ctapang/CondoUnitAvalonGen2/BCMINER V2-1 GERBER FILES/Images/_bcminer.bmp

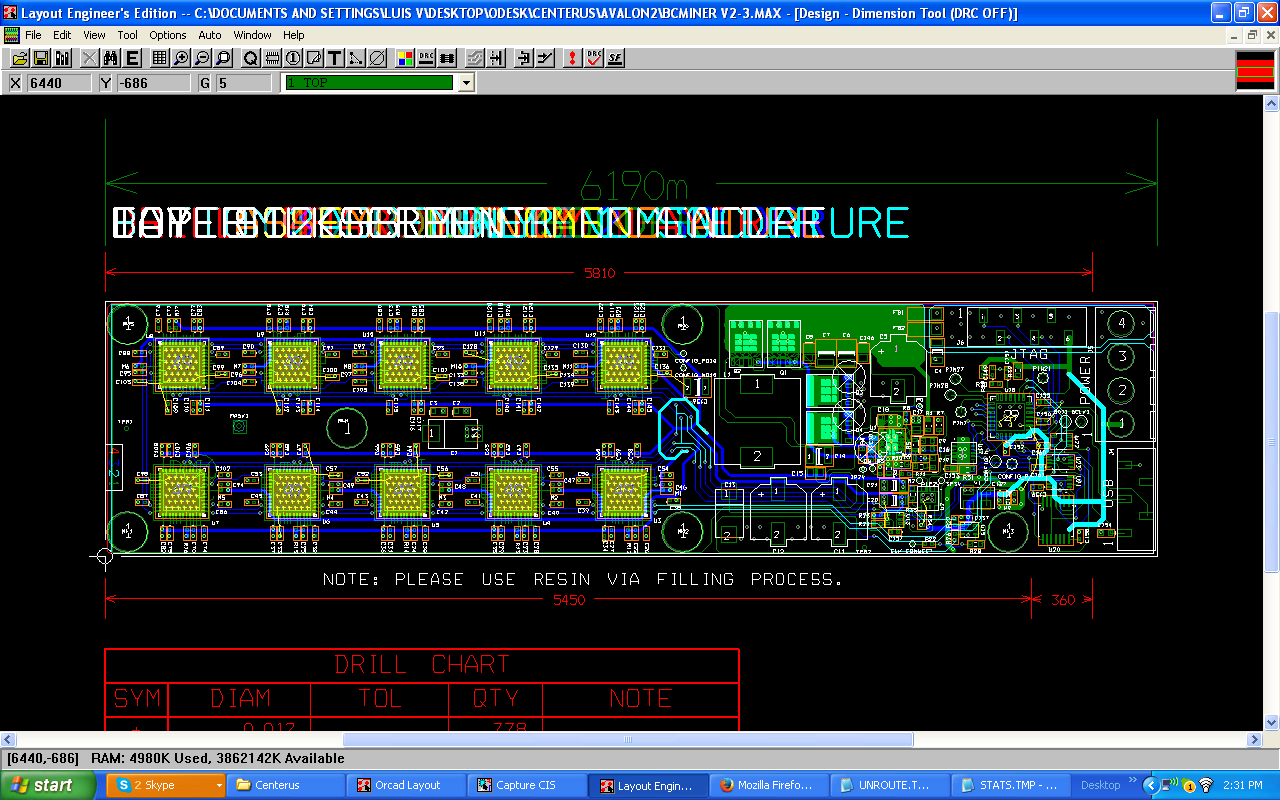
BCMINER V2-1 GERBER FILES/Images/_bcminer.bmp
