ctapang/CondoUnitAvalonGen2/BCMINER V2-1 GERBER FILES/Images/BCMINER V2-1 ASSY_CROPPED.png

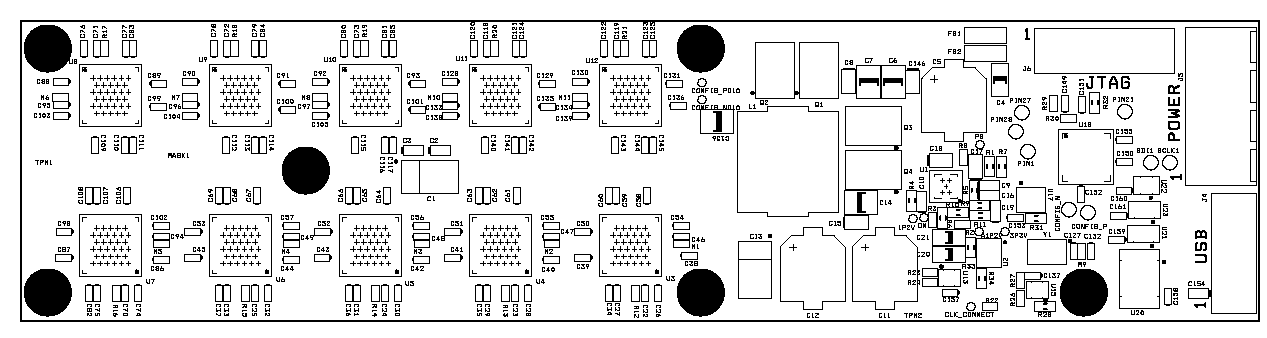
BCMINER V2-1 GERBER FILES/Images/BCMINER V2-1 ASSY_CROPPED.png
