ctapang/CondoUnitAvalonGen2/BCMINER V2-1 ORCAD FILES/BCMINER V2-1 BOM.xlsx

POWER SUPPLY Revised: Friday, November 22, 2013 |  |  |  |  |  | Page1
1000-001 Revision: 2-1
Centerus, Inc.
Bill Of Materials November 22,2013 13:20:07
Item | Quantity | Reference | Value | Description | Part Number | Manufacturer
1 | 2 | C1,C13 | 680uF/2.5V | CAP TANT 680UF 2.5V 20% 2917 | T530D687M2R5ATE010 | KEMET
2 | 2 | C2,C3 | 4.7uF | CAP CER 4.7UF 10V 10% X5R 0603 | CGB3B1X5R1A475K055AC | TDK
3 | 1 | C4 | 10uF/16V | CAP CER 10UF 16V 20% X7R 1206 | C3216X7R1C106M160AC | TDK
4 | 1 | C5 | 270uF/16V | CAP ALUM 270UF 16V 20% SMD | PCV1C271MCL1GS | NICHIHON
5 | 2 | C6,C7 | 22uF/16V | CAP CER 22UF 16V 20% X7R 1210 | C3225X7R1C226M250AC | TDK
6 | 3 | C8,C17,C146 | 4.7uF/16V | CAP CER 4.7UF 16V 10% X7R 0805 | CGA4J3X7R1C475K125AB | TDK
7 | 1 | C9 | 6800pF | CAP CER 6800PF 50V 20% X7R 0603 | CEU3E2X7R1H682M080AE | TDK
8 | 2 | C10,C154 | 1uF/20V | CAP CER 1UF 25V 10% X7R 0603 | C1608X7R1E105K080AB | TDK
9 | 2 | C11,C12 | 1500uF/2.5V | CAP ALUM 1500UF 2.5V 20% SMD | PCJ0E152MCL1GS | NICHIHON
10 | 2 | C14,C156 | 47uF | CAP CER 47UF 10V 20% X5R 1210 | LMK325BJ476MM-T | TAIYO YUDEN
11 | 2 | C15,C18 | 10uF | CAP CER 10UF 10V 10% X5R 0805 | C2012X5R1A106K125AB | TDK
12 | 1 | C16 | 390pF | CAP CER 390PF 50V 5% NP0 0603 | C1608C0G1H391J080AA | TDK
13 | 1 | C19 | 4700pF | CAP CER 4700PF 50V 5% NP0 0603 | C1608C0G1H472J080AA | TDK
14 | 2 | C20,C21 | 22uF/10V | CAP CER 22UF 10V 20% X5R 1206 | C3216X5R1A226M160AC | TDK
15 | 124 | C22,C23,C24,C25,C26,C27,C28,C29,C30,C31,C32,C33,C34,C35,C36,C37,C38,C39,C40,C41,C42,C43,C44,C45,C46,C47,C48,C49,C50,C51,C52,C53,C54,C55,C56,C57,C58,C59,C60,C61,C62,C63,C64,C65,C66,C67,C68,C69,C70,C71,C72,C73,C74,C75,C76,C77,C78,C79,C80,C81,C82,C83,C84,C85,C86,C87,C88,C89,C90,C91,C92,C93,C94,C95,C96,C97,C98,C99,C100,C101,C102,C103,C104,C105,C106,C107,C108,C109,C110,C111,C112,C113,C114,C115,C116,C117,C118,C119,C120,C121,C122,C123,C124,C125,C127,C128,C129,C130,C131,C132,C133,C134,C135,C136,C137,C138,C139,C140,C141,C142,C143,C144,C145,C157 | 0.47uF | CAP CER 0.47UF 6.3V 10% X5R 0402 | C1005X5R0J474K050BB | TDK
16 | 10 | C149,C150,C151,C152,C153,C155,C158,C159,C160,C161 | 0.1uF | CAP CER 0.1UF 6.3V 10% X5R 0402 | C1005X5R0J104K050BA | TDK
17 | 2 | FB1,FB2 | MB | FERRITE BEAD 30 OHM 3.0A 1210 | 742792310 | WURTH
18 | 1 | J4 | USB | 5POS SIL VERTICAL SMT HEADER | M20-8770546 | HARWIN
19 | 1 | J5 | POWER | TERM BLOCK PCB 4POS 5.0MM GREEN | 1935187 | PHOENIX
20 | 1 | J6 | JTAG | 6POS SIL VERTICAL SMT HEADER | M20-8770646 | HARWIN
21 | 1 | L1 | IHLP5050FDER | INDUCTOR POWER 1.0UH 32A SMD | IHLP5050FDER1R0M01 | VISHAY
22 | 11 | M1,M2,M3,M4,M5,M6,M7,M8,M9,M10,M11 | MB | FERRITE CHIP .5A 60 OHM SMD 0402 | LI0402E600R-10 | LAIRD
23 | 1 | Q1 | CSD16321Q5C | MOSFET N-CH 25V 100A 8SON | CSD16321Q5C | TI
24 | 2 | Q3,Q4 | CSD16403Q5A | MOSFET N-CH 25V 100A 8-SON | CSD16403Q5A | TI
25 | 5 | R1,R4,R26,R27,R28 | 0R | RES 0.0 OHM 1/10W JUMP 0603 SMD | ERJ-3GEY0R00V | PANASONIC
26 | 1 | R3 | 1K | RES 1K OHM 1/10W 1% 0402 SMD | ERJ-2RKF1001X | PANASONIC
27 | 1 | R5 | 7.32K | RES 7.32K OHM 1/10W 1% 0603 SMD | ERJ-3EKF7321V | PANASONIC
28 | 1 | R6 | 10K | RES 10K OHM 1/10W 1% 0603 SMD | ERJ-3EKF1002V | PANASONIC
29 | 1 | R7 | 3.9K | RES 3.9K OHM 1/10W 1% 0603 SMD | ERJ-3EKF3901V | PANASONIC
30 | 11 | R8,R12,R13,R14,R15,R16,R17,R18,R19,R20,R21 | 100K | RES 100K OHM 1/10W 1% 0402 SMD | ERJ-2RKF1003X | PANASONIC
31 | 1 | R9 | 3.32K 1% | RES 3.32K OHM 1/10W 1% 0603 SMD | ERJ-3EKF3321V | PANASONIC
32 | 1 | R10 | 3.83K 1% | RES 3.83K OHM 1/10W 1% 0603 SMD | ERJ-3EKF3831V | PANASONIC
33 | 1 | R11 | 549R | RES 549 OHM 1/10W 1% 0603 SMD | ERJ-3EKF5490V | PANASONIC
34 | 1 | R22 | 100R | RES 100 OHM 1/10W 1% 0402 SMD | ERJ-2RKF1000X | PANASONIC
35 | 3 | R23,R24,R30 | 470R | RES 470 OHM 1/10W 1% 0402 SMD | ERJ-2RKF4700X | PANASONIC
36 | 1 | R29 | 10K | RES 10K OHM 1/10W 1% 0402 SMD | ERJ-2RKF1002X | PANASONIC
37 | 1 | R31 | 51.1K | RES 51.1K OHM 1/10W 1% 0603 SMD | ERJ-3EKF5112V | PANASONIC
38 | 1 | R32 | 10R | RES 10 OHM 1/10W 5% 0603 SMD | ERJ-3GEYJ100V | PANASONIC
39 | 1 | R33 | 9.1K 1% | RES 9.1K OHM 1/10W 1% 0603 SMD | ERJ-3EKF9101V | PANASONIC
40 | 1 | R34 | 36K 1% | RES 36K OHM 1/10W 1% 0603 SMD | ERJ-3EKF3602V | PANASONIC
41 | 1 | U1 | TPS40193 | IC REG CTRLR BUCK PWM VM 10-SON | TPS40193DRCT | TI
42 | 1 | U2 | RT9187GQV | IC REG LDO ADJ 1A 8VDFN | RT9187GQV | RICHTEK
43 | 10 | U3,U4,U5,U6,U7,U8,U9,U10,U11,U12 | A3255-Q48 | A3255-Q48 SHA256 PROCESSOR | A3255-Q48 | AVALON
44 | 2 | U13,U15 | 74LVC2G34 | IC BUFFER DUAL NON-INV SC706 | SN74LVC2G34DCKR | TI
45 | 1 | U17 | LM10011SD/NOPB | IC VID VOLTAGE PROGRAMMER 10SON | LM10011SD/NOPB | TI
46 | 1 | U18 | PIC32MX250F128B-I/ML | IC MCU 32BIT 128KB FLASH 28-QFN | PIC32MX250F128B-I/ML | MICROCHIP
47 | 1 | U20 | SN74LVC32APWR | IC QUAD 2-IN OR GATE 14-TSSOP | SN74LVC32APWR | TI
48 | 1 | U21 | SN74LVC3G04DCUR | IC TRIPLE INVERTER GATE US8 | SN74LVC3G04DCUR | TI
49 | 1 | U22 | SN74LVC1G79DCKR | IC D-TYPE POS TRG SNGL SC70-5 | SN74LVC1G79DCKR | TI
50 | 1 | U23 | SN74LVC2G08DCUR | IC DUAL 2-IN POS-AND GATE US8 | SN74LVC2G08DCUR | TI
51 | 1 | Y1 | OSC_25M | OSCILLATOR 25.000 MHZ 3.3V SMD | ASFL1-25.000MHZ-EK-T | ABRACON
