ctapang/CondoUnitAvalonGen2/BCMINER V2-1 ORCAD FILES/DigiKeyOrder-BOM.xlsx

Web ID | Access ID | Salesorder Number | Shipping Method | Payment Method | Purchase Order
49627180 | 22472 | 37970293 | UPS World Wide Saver | VISA | 20131120001
Shipping Address
First Name | Last Name | Company | Mail Stop | Address Line 1 | Address Line 2 | City | State | Postal Code | Country | Email Address | Telephone
Jon | Jarantilla | Precision MicroCircuits Inc. | Centerus | Mactan Economic Zone 1 |  | Lapu-Lapu City | Cebu | 6015 | PHILIPPINES | ctapang@centerus.com | -5158
Billing Address
First Name | Last Name | Company | Mail Stop | Address Line 1 | Address Line 2 | City | State | Postal Code | Country | Email Address | Telephone
Carlos | Tapang | Centerus Inc |  | 93 S Jackson St # 21970 |  | Seattle | WA | 98104 | USA |  | 4257380222
Index | Quantity | Part Number | Description | Customer Reference | Available Quantity | Backorder Quantity | Unit Price USD | Extended Price USD
1 | 4 | 952-1951-ND | 3POS SIL VERTICAL SMT HEADER | CENTERUS CONDO MINER | 4 | 0 | 0.26 | $1.04
2 | 2 | 535-9262-6-ND | OSCILLATOR 25.000MHZ 3.3V SMD | CENTERUS CONDO MINER | 2 | 0 | 6.31 | $12.62
3 | 2 | 296-13264-6-ND | IC DUAL 2-IN POS-AND GATE US8 | CENTERUS CONDO MINER | 2 | 0 | 4.2 | $8.40
4 | 2 | 296-9850-6-ND | IC D-TYPE POS TRG SNGL SC70-5 | CENTERUS CONDO MINER | 2 | 0 | 3.9 | $7.80
5 | 2 | 296-13279-6-ND | IC TRIPLE INVERTER GATE US8 | CENTERUS CONDO MINER | 2 | 0 | 4.24 | $8.48
6 | 2 | 296-1236-6-ND | IC QUAD 2-IN OR GATE 14-TSSOP | CENTERUS CONDO MINER | 2 | 0 | 3.94 | $7.88
7 | 2 | PIC32MX250F128B-I/ML-ND | IC MCU 32BIT 128KB FLASH 28-QFN | CENTERUS CONDO MINER | 2 | 0 | 4.42 | $8.84
8 | 2 | 296-35633-6-ND | IC VID VOLTAGE PROGRAMMER 10SON | CENTERUS CONDO MINER | 2 | 0 | 5.22 | $10.44
9 | 4 | 296-13497-6-ND | IC BUFFER DUAL NON-INV SC706 | CENTERUS CONDO MINER | 4 | 0 | 2.34 | $9.36
10 | 2 | 1028-1071-1-ND | IC REG LDO ADJ 1A 8VDFN | CENTERUS CONDO MINER | 2 | 0 | 0.68 | $1.36
11 | 2 | 296-21677-6-ND | IC REG CTRLR BUCK PWM VM 10-SON | CENTERUS CONDO MINER | 2 | 0 | 6.37 | $12.74
12 | 2 | P36.0KHDKR-ND | RES 36K OHM 1/10W 1% 0603 SMD | CENTERUS CONDO MINER | 2 | 0 | 3.6 | $7.20
13 | 2 | P9.10KHDKR-ND | RES 9.1K OHM 1/10W 1% 0603 SMD | CENTERUS CONDO MINER | 2 | 0 | 3.6 | $7.20
14 | 2 | P10GDKR-ND | RES 10 OHM 1/10W 5% 0603 SMD | CENTERUS CONDO MINER | 2 | 0 | 3.6 | $7.20
15 | 2 | P51.1KHDKR-ND | RES 51.1K OHM 1/10W 1% 0603 SMD | CENTERUS CONDO MINER | 2 | 0 | 3.6 | $7.20
16 | 2 | P10.0KLDKR-ND | RES 10K OHM 1/10W 1% 0402 SMD | CENTERUS CONDO MINER | 2 | 0 | 3.6 | $7.20
17 | 6 | P470LDKR-ND | RES 470 OHM 1/10W 1% 0402 SMD | CENTERUS CONDO MINER | 6 | 0 | 1.26667 | $7.60
18 | 2 | P100LDKR-ND | RES 100 OHM 1/10W 1% 0402 SMD | CENTERUS CONDO MINER | 2 | 0 | 3.6 | $7.20
19 | 2 | P549HDKR-ND | RES 549 OHM 1/10W 1% 0603 SMD | CENTERUS CONDO MINER | 2 | 0 | 3.6 | $7.20
20 | 2 | P3.83KHDKR-ND | RES 3.83K OHM 1/10W 1% 0603 SMD | CENTERUS CONDO MINER | 2 | 0 | 3.6 | $7.20
21 | 2 | P3.32KHDKR-ND | RES 3.32K OHM 1/10W 1% 0603 SMD | CENTERUS CONDO MINER | 2 | 0 | 3.6 | $7.20
22 | 22 | P100KLDKR-ND | RES 100K OHM 1/10W 1% 0402 SMD | CENTERUS CONDO MINER | 22 | 0 | 0.41818 | $9.20
23 | 2 | P3.90KHDKR-ND | RES 3.9K OHM 1/10W 1% 0603 SMD | CENTERUS CONDO MINER | 2 | 0 | 3.6 | $7.20
24 | 2 | P10.0KHDKR-ND | RES 10K OHM 1/10W 1% 0603 SMD | CENTERUS CONDO MINER | 2 | 0 | 3.6 | $7.20
25 | 2 | P7.32KHDKR-ND | RES 7.32K OHM 1/10W 1% 0603 SMD | CENTERUS CONDO MINER | 2 | 0 | 3.6 | $7.20
26 | 2 | P1.00KLDKR-ND | RES 1K OHM 1/10W 1% 0402 SMD | CENTERUS CONDO MINER | 2 | 0 | 3.6 | $7.20
27 | 10 | P0.0GDKR-ND | RES 0.0 OHM 1/10W JUMP 0603 SMD | CENTERUS CONDO MINER | 10 | 0 | 0.8 | $8.00
28 | 4 | 296-24249-6-ND | MOSFET N-CH 25V 100A 8-SON | CENTERUS CONDO MINER | 4 | 0 | 3.47 | $13.88
29 | 2 | 296-25643-6-ND | MOSFET N-CH 25V 100A 8SON | CENTERUS CONDO MINER | 2 | 0 | 5.65 | $11.30
30 | 22 | 240-2363-6-ND | FERRITE CHIP .5A 60 OHM SMD | CENTERUS CONDO MINER | 22 | 0 | 0.39 | $8.58
31 | 2 | 541-1032-6-ND | INDUCTOR POWER 1.0UH 32A SMD | CENTERUS CONDO MINER | 2 | 0 | 11.17 | $22.34
32 | 2 | 277-7679-ND | CONN TERM BLK 4POS 9.52MM GRN | CENTERUS CONDO MINER | 2 | 0 | 3.09 | $6.18
33 | 2 | 952-1975-ND | 5POS SIL VERTICAL SMT HEADER | CENTERUS CONDO MINER | 2 | 0 | 0.36 | $0.72
34 | 4 | 732-1631-6-ND | FERRITE BEAD 30 OHM 3.0A 1210 | CENTERUS CONDO MINER | 4 | 0 | 2.08 | $8.32
35 | 20 | 445-1266-6-ND | CAP CER 0.1UF 6.3V 10% X5R 0402 | CENTERUS CONDO MINER | 20 | 0 | 0.376 | $7.52
36 | 248 | 445-4996-6-ND | CAP CER 0.47UF 6.3V 10% X5R 0402 | CENTERUS CONDO MINER | 248 | 0 | 0.06121 | $15.18
37 | 4 | 445-6004-6-ND | CAP CER 22UF 10V 20% X5R 1206 | CENTERUS CONDO MINER | 4 | 0 | 2.76 | $11.04
38 | 2 | 445-7400-6-ND | CAP CER 4700PF 50V 5% NP0 0603 | CENTERUS CONDO MINER | 2 | 0 | 3.74 | $7.48
39 | 2 | 445-1288-6-ND | CAP CER 390PF 50V 5% NP0 0603 | CENTERUS CONDO MINER | 2 | 0 | 3.6 | $7.20
40 | 4 | 445-7660-6-ND | CAP CER 10UF 10V 10% X5R 0805 | CENTERUS CONDO MINER | 4 | 0 | 1.95 | $7.80
41 | 4 | 587-1383-6-ND | CAP CER 47UF 10V 20% X5R 1210 | CENTERUS CONDO MINER | 4 | 0 | 2.72 | $10.88
42 | 4 | 399-4130-6-ND | CAP TANT 680UF 2.5V 20% 2917 | CENTERUS CONDO MINER | 4 | 0 | 8.52 | $34.08
43 | 4 | 493-3026-6-ND | CAP ALUM 1500UF 2.5V 20% SMD | CENTERUS CONDO MINER | 4 | 0 | 3.77 | $15.08
44 | 4 | 445-5956-6-ND | CAP CER 1UF 25V 10% X7R 0603 | CENTERUS CONDO MINER | 4 | 0 | 1.99 | $7.96
45 | 2 | 445-12023-6-ND | CAP CER 6800PF 50V 20% X7R 0603 | CENTERUS CONDO MINER | 2 | 0 | 3.76 | $7.52
46 | 6 | 445-6969-6-ND | CAP CER 4.7UF 16V 10% X7R 0805 | CENTERUS CONDO MINER | 6 | 0 | 1.50667 | $9.04
47 | 4 | 445-3955-6-ND | CAP CER 22UF 16V 20% X7R 1210 | CENTERUS CONDO MINER | 4 | 0 | 2.59 | $10.36
48 | 2 | 493-4365-6-ND | CAP ALUM 270UF 16V 20% SMD | CENTERUS CONDO MINER | 2 | 0 | 6 | $12.00
49 | 2 | 445-1601-6-ND | CAP CER 10UF 16V 20% X7R 1206 | CENTERUS CONDO MINER | 2 | 0 | 3.84 | $7.68
50 | 4 | 445-7482-6-ND | CAP CER 4.7UF 10V 10% X5R 0603 | CENTERUS CONDO MINER | 4 | 0 | 1.99 | $7.96
 |  |  |  |  |  | Subtotal | $457.46
 |  |  |  |  |  | Shipping | $40.00
 |  |  |  |  |  | Total | $497.46
