ctapang/CondoUnitAvalonGen2/BCMINER V2-1 ORCAD FILES/BCMINER V2-1 SCHEMATICS.pdf

## 1.2V Regulator

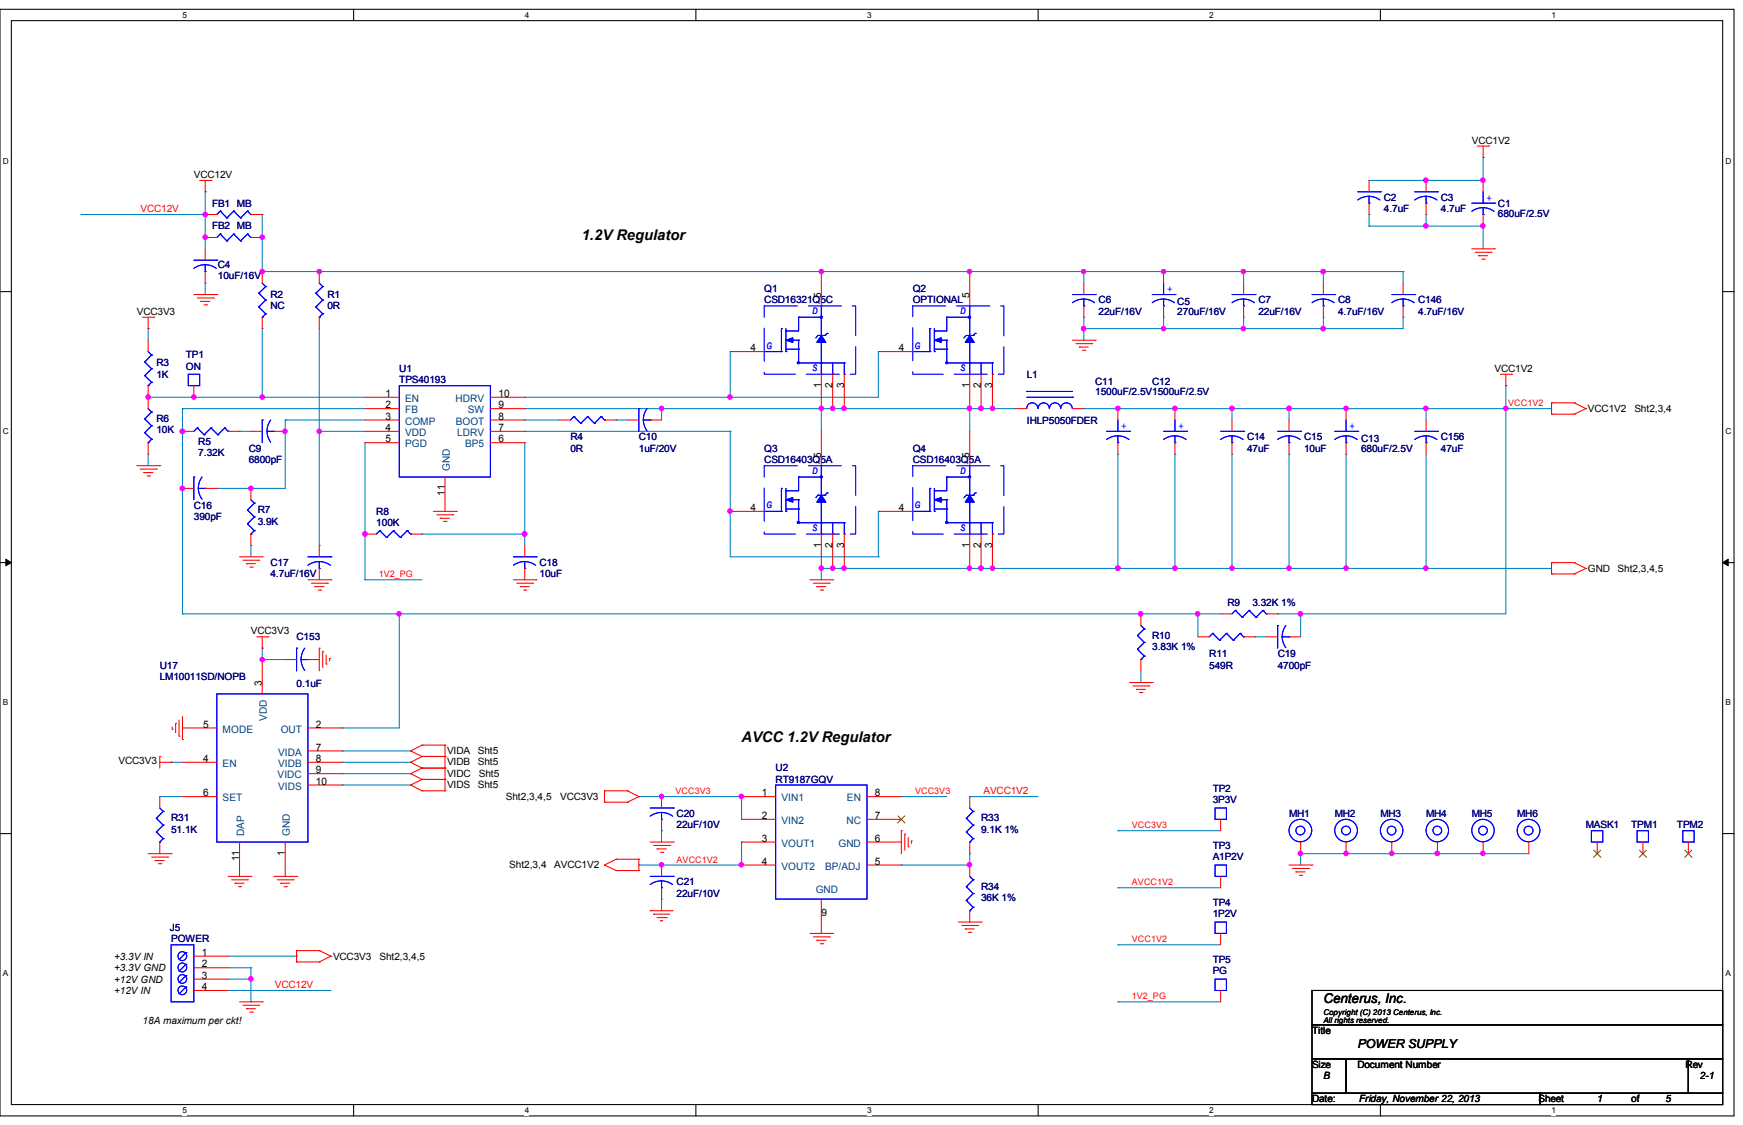
[picture p3: page 1]

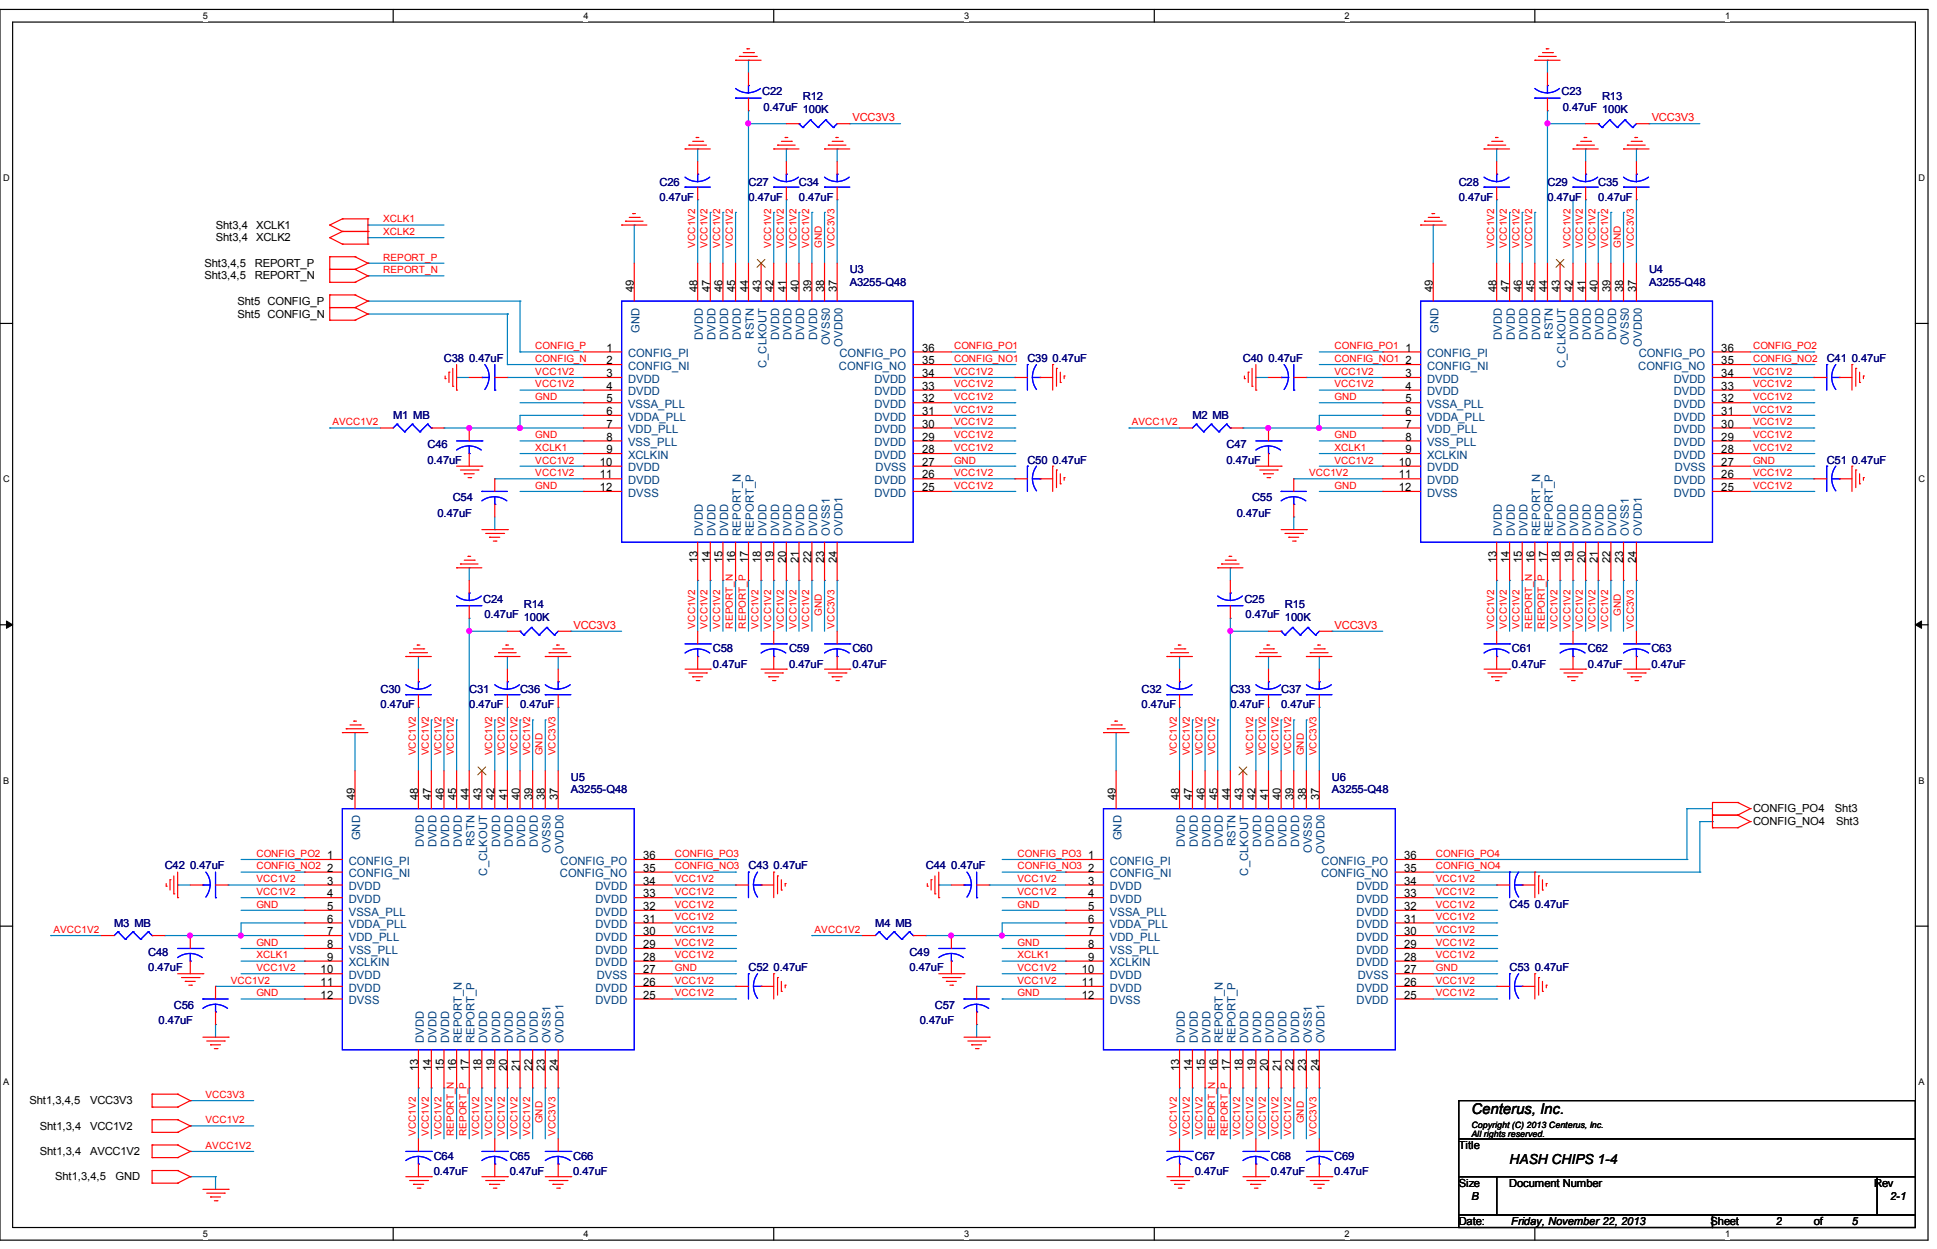
[picture p4: page 2]

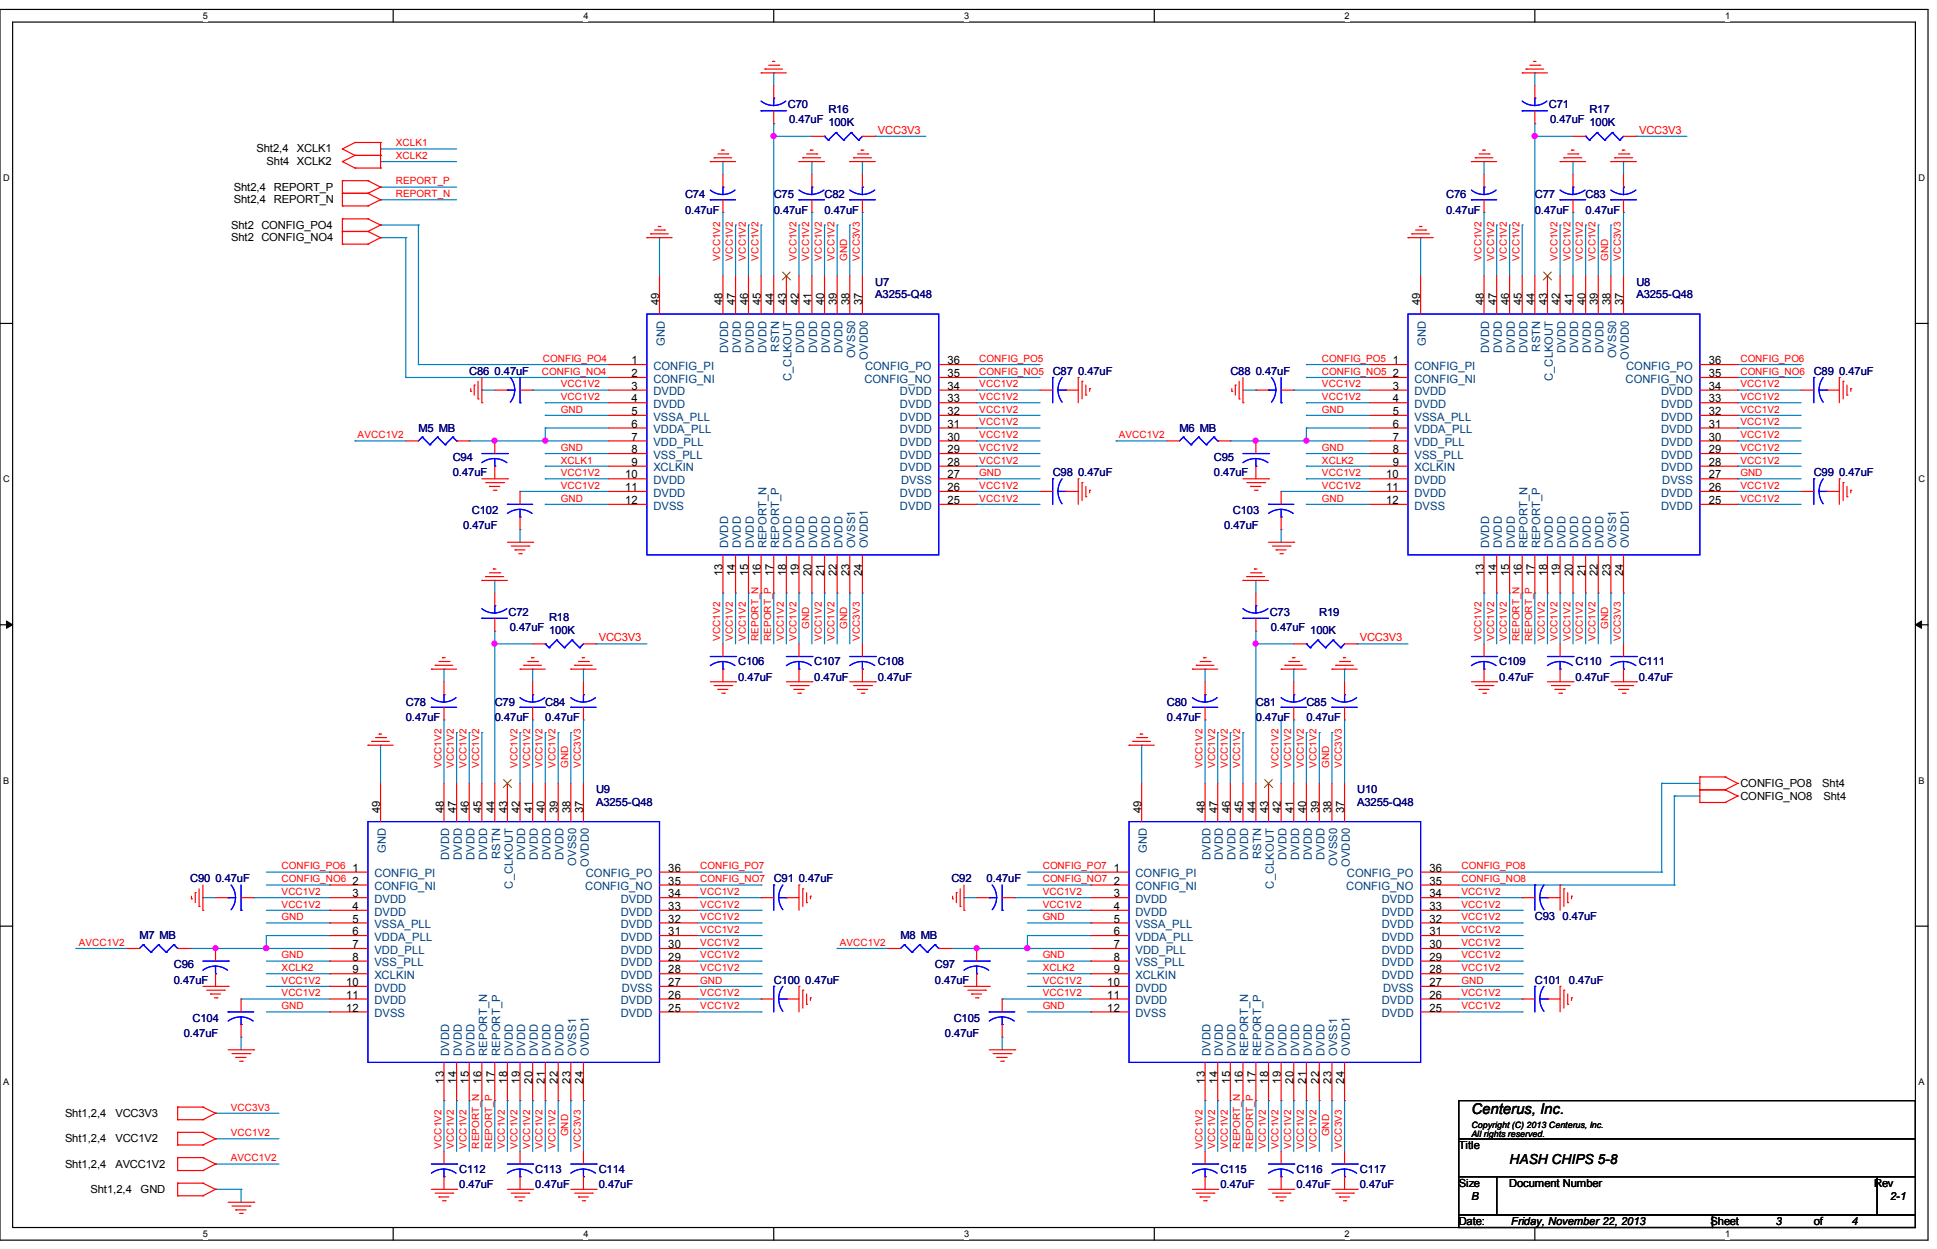
[picture p5: page 3]

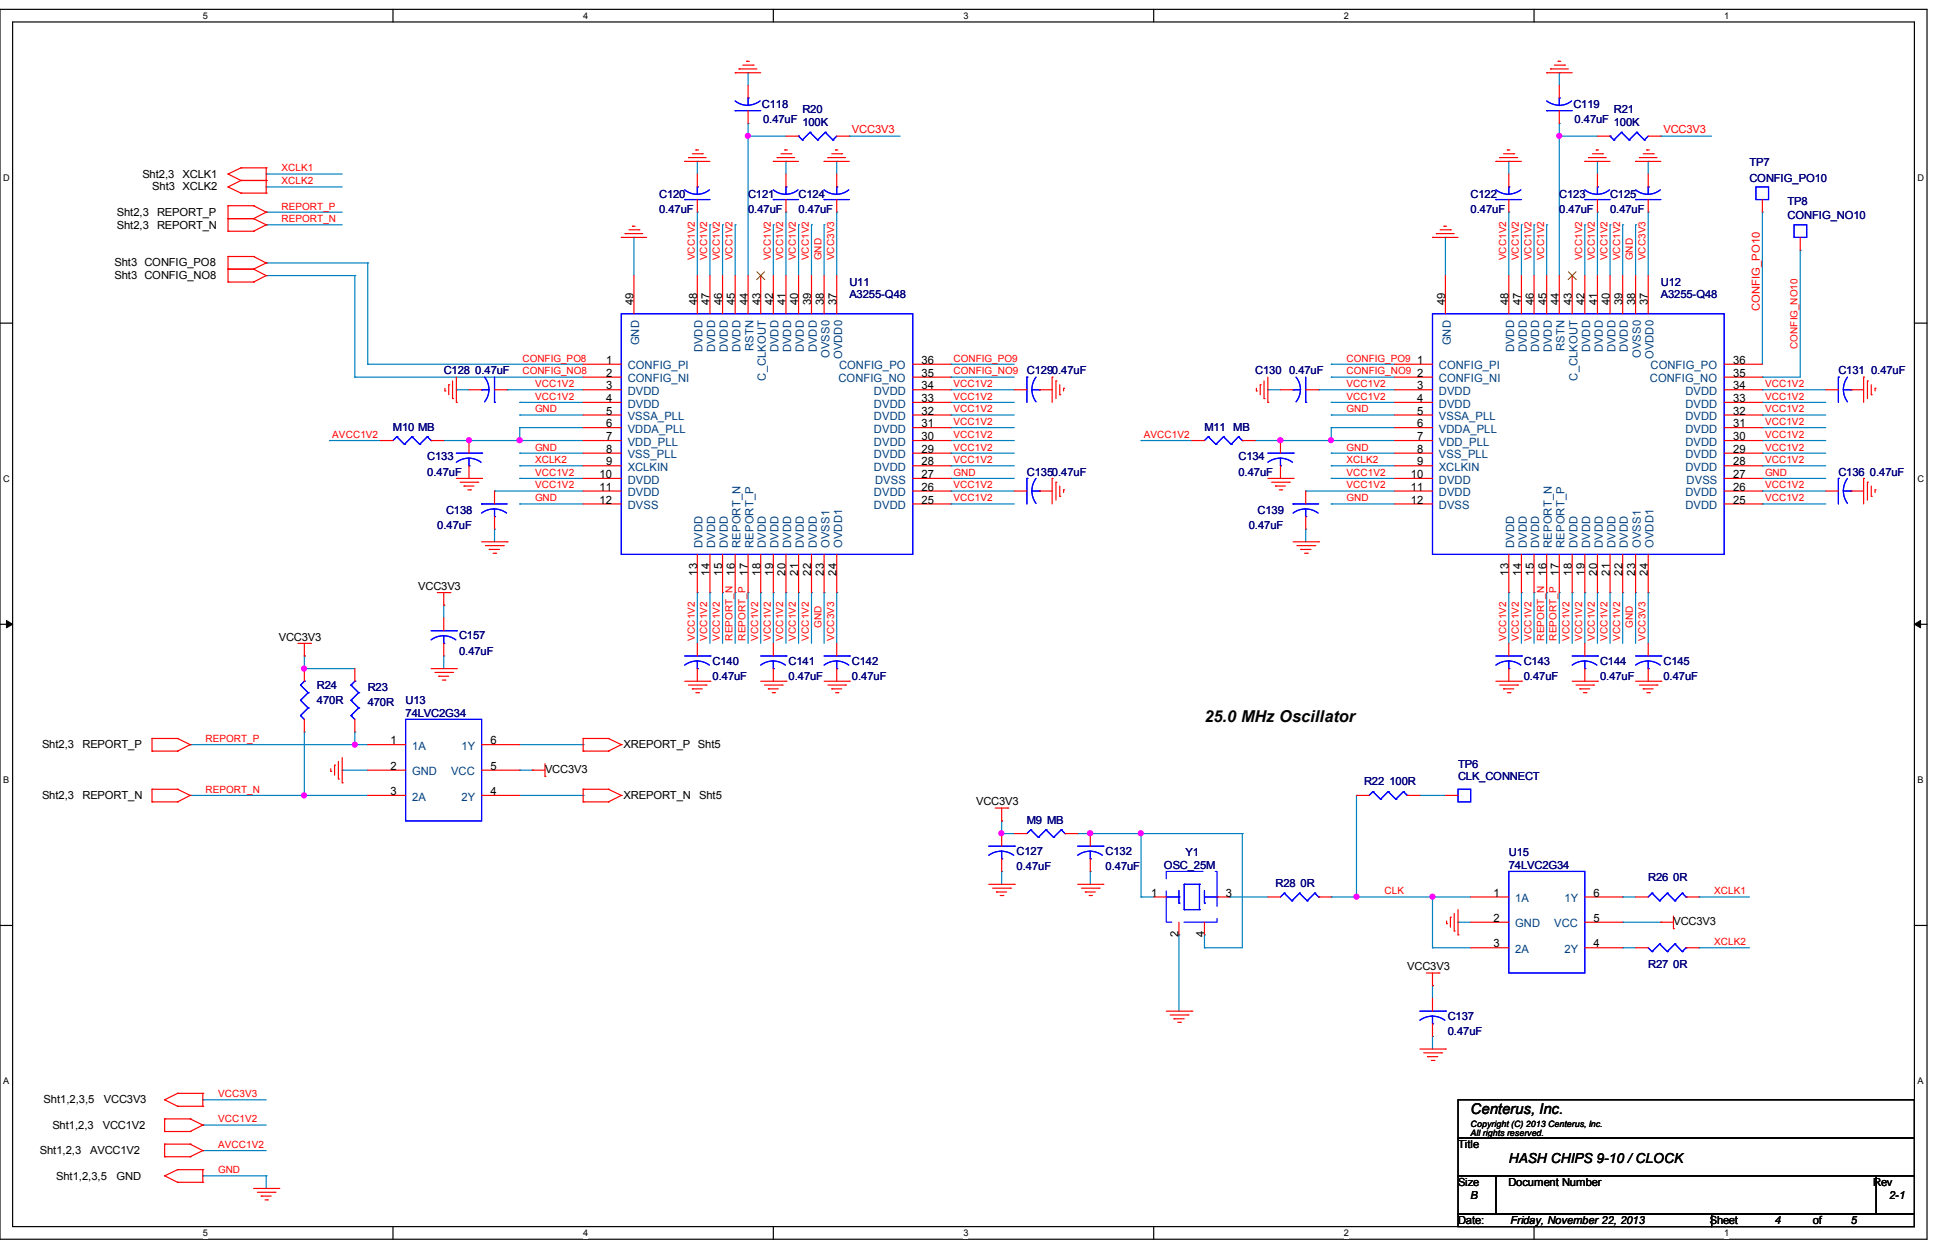
[picture p6: page 4]

## USB Interface (Implemented as a DEVICE)

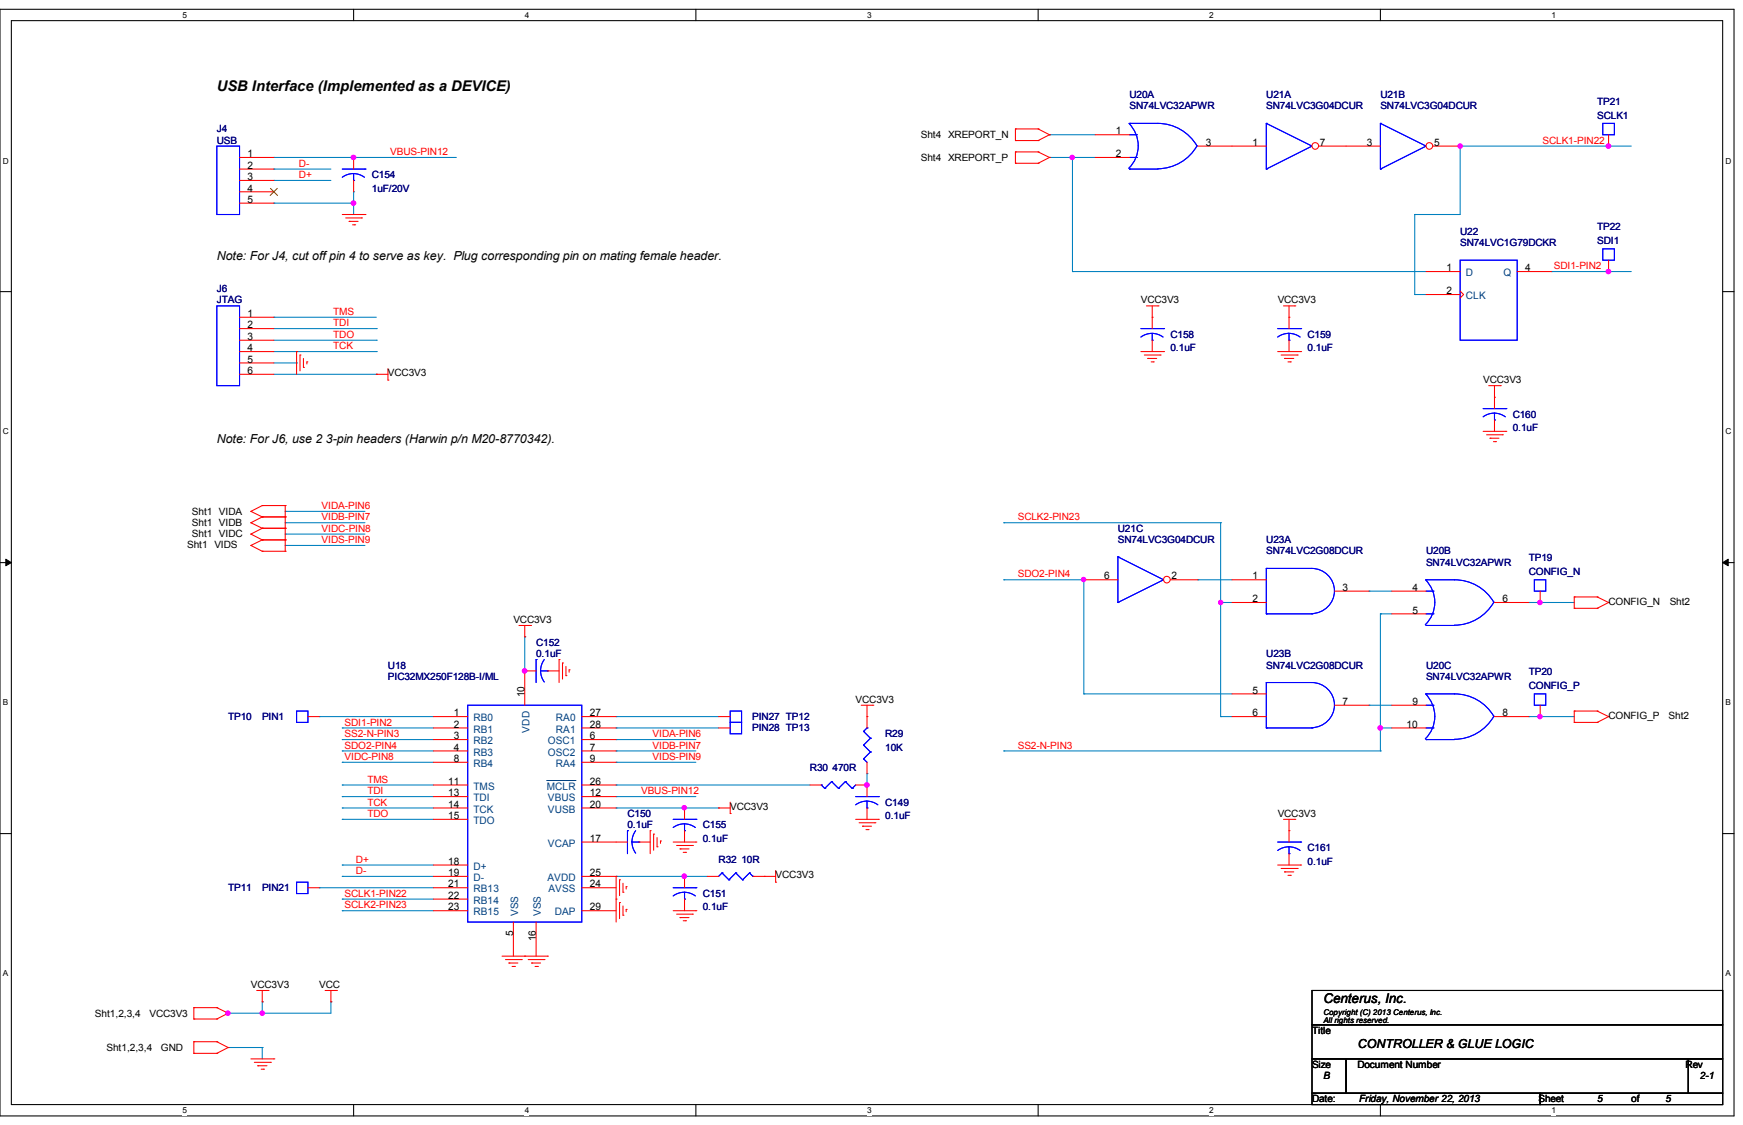
[picture p7: page 5]

Note: For J4, cut off pin 4 to serve as key. Plug corresponding pin on mating female header.

Note: For J6, use 2 3-pin headers (Harwin p/n M20-8770342).
