ctapang/CondoUnitAvalonGen2/BCMINER V2-1 ORCAD FILES/BCMINER V2-1 ASSY.pdf

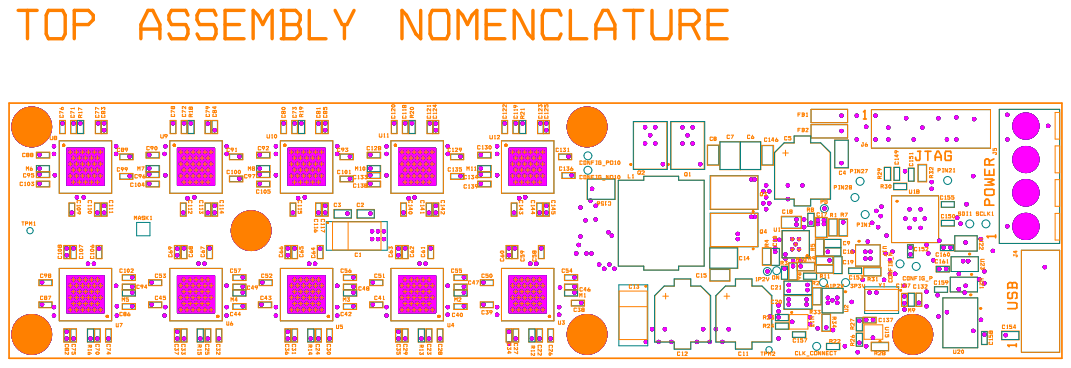
[picture p8: page 1]
