ctapang/CondoUnitAvalonGen2/BCMINER V2-1 ORCAD FILES/BCMINER V2-1 TOP LAYER.pdf

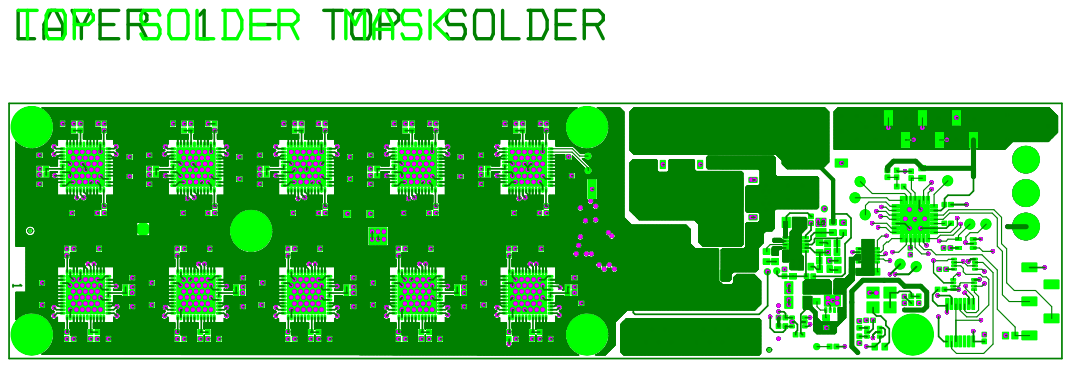
[picture p9: page 1]
