ctapang/CondoUnitAvalonGen2/(list of files, drawings)

Other design files:
BCMINER V2-1 ORCAD FILES/BCMINER V2-1.DSN
BCMINER V2-1 ORCAD FILES/BCMINER V2-1.OPJ
BCMINER V2-1 ORCAD FILES/CENTERUS.OLB
